MinosCodes/cdjay/docs/CDJ-800.md

# CDJ-800

## Introduction
The CDJ-800 MK2, unlike the CDJ-100, but like the 200, has a dedicated board with an own controller for the switches, jog dial etc. This means that we do not need to implement an own controller circuit, but can 'just' communicate with the interface board.

## Mainboard Connectors
The Mainboard has two connectors for the CD-Player. These are not relevant for our project. We could think of adding connectors just to not have them dangling around. 
- CN102 for the spindle motor
- CN101 towards CN1101
The MAIN ASSY has two connectors relevant for our endeavour. CN301 (CD53) to the SECB ASSY and CN701 (CN801) to the JACK ASSY.

### CN301 (CK4192 - - TBB, 1MM Pitch FFC ZIF)
Pin | I/O | Description | Use?
----|-----|-------------|-----
1  |  -  | V+7M |
2  |  -  | V+7M | 
3  |  -  | V+7M | 
4  | - | GNDM |
5  | - | GNDM | 
6  | - | GNDM | 
7  | - | V+8A | (Comes from CN701) 
8  | - | V+3D |
9  | - | V+3D |
10 | - | GNDD | 
11 | - | GNDD | 
12 | - | GNDD | 
13 | - | GNDD | 
14 | - | GNDD | 
15 | - | V+6B | 
16 | - | GNDS |
17 | - | V+5P |
18 | I/O | JSDATA | 
19 | I | TSDI | Data IN
20 | I | RMIN |
21 | O | TSCS | Cable Select
22 | I/O | CONT1 | 
23 | O | TSDO | Data Out
24 | I/O | CONT2 | 
25 |  O | TSCLK | Clock

### CN701 (CK4176 - - TBB, 1MM Pitch FFC ZIF)
Pin | I/O | Description | Use?
----|-----|-------------|-----
1  |  O  | LOUT | Left audio output channel
2  |  -  | GNDA | Audio Ground
3  |  -  | GNDA | 
4  |  O  | ROUT | R audio output channel
5  | - | V+8A | 
6  | O | MUTE | Mutes the audio output
7  | -  | V-7A | 
8  | O | GNDDOUT | GND for digital audio output
9  | O | DOUT | Digital audio outpout

### Power Supply

What we we need: and I think that all comes from external, so we don't need to generate anything. (See Page 20)
V+7M 
V+8A
V+3D
V+6B
V+5P

On the regulator board, there are two ICs: IC92 and IC91. 
IC91: Takes V+6B and delivers V+3D
IC92: Takes V+10B and delivers V+7A

### References
 - [https://forum.arduino.cc/t/hacking-cdj800-display-communication-protocol/1133083?page=3]
 - [https://www.youtube.com/@edescrambler/videos]
 - [https://github.com/djgreeb/CDJ-1000mk3_new_life_project/blob/master/Reverse%20Engineering%20Pioneer%20CDJ-1000%20serial%20protocol.pdf]
 - [https://github.com/AlejandroPerez92/cdj800spi]
