MinosCodes/cdjay/docs/CDJ-100.md

# CDJ-100
## Intro

## Board Analysis
All CDJ-100 controls (buttons, sliders, etc.) are mounted on a board that sits in the top half of the shelf and is connected to the mainboard through a 36-Pin flex cable. 

The service manual lists the following pin labels:
CN701 - CN601
Pin | I/O | Description | Use?
----|-----|-------------|-----
1  |  -  | V+5V |
2  |  I  | ADIN | Pitch slider voltage input.
3  |  I  | CT | Slider center tap voltage input.
4  | _ | GNDD|
5  | I | JOG1 | Jog Wheel Encoder. V+5V -> GNDS. Interrupt input for jog dial pulses
6  | I | JOG2 | Jog Wheel Encoder. Jog dial pulse input
7  | I |KD2 | Key return lines. Pulled High when one of the switches is pressed
8  | I | KD1 |
9  | I | KD0 |
10 | O | S12 | FL segment output
11 | O | S1 | FL segment output To HOLD (KD0), TRKB (KD1), Play (KD2) switch
12 | O | S2 | To TIME (KD0), TRKF (KD1), CUE (KD2) switch
13 | O | S3 | To EJECT (KD0), JET (KD1), SCNB (KD2) switch 
14 | O | S4 | To MT (Master Tempo) (KD0), ZIP (KD1), SCNF (KD2) switch  Connected to Flip-Flop for LED on/off
15 | O | S5 | WAH Switch to KD1
16 | O | S6 |
17 | O | S7 |
18 | O | S8 | Connected to Flip-Flop for LED on/off
19 | O | S9 | Connected to Flip-Flop for LED on/off
20 | O | S10 |
21 | O | S11 |
22 | O | G11 | FL grid output 
23 | O | G10 |
24 | O | G9 | FL grid output  
25 |  O | G8 | 
26 |  O | G7 |
27 |  O | G6 |
28 |  O | G5 |
29 |  O | G4 |
30 |  O | G3 |
31 |  O | G2 |
32 |  O | G1 | Clock Input for Flip-Flop
33 |  - | V-BV | Voltage for the Play/Cue/Disc/Window LEDs
34 |  - | AC2 | AC Voltage for the LCD (Either 5V AC or 3V AC)
35 | - | GNDS |
36 | - | AC1 | AC Voltage for the LCD

To control all that, we need 

| No.| Purpose | 
| -- | -- |
| 1  |  ADC Input| 
| 1 | CT line
| 2 | Jog Wheel |
| 3 | Button Input | 
| 11 | G-Lines |
| 12 | S-Lines | 
|  | |
| 30 | Sum | 

### Switches: 
There are 13 switches in total

S601: TRACK SEARCH (<<)
S602: SEARCH (<<)
S603: PLAY/PAUSE 
S604: TRACK SEARCH (>>)
S605: SEARCH (>>)
S606: CUE
S607: DIGITAL JOG BREAK (JET)
S608: MASTER TEMPO
S609: DIGITAL JOG BREAK (ZIP)
S610: DIGITAL JOG BREAK (WAH)
S611: EJECT 
S613: TIME MODE/AUTO CUE
S615: DIGITAL JOG BREAK (HPLD)

The Transformer Board Assembly has the following outputs:
CN705
Pin | Description | Use?
----|-------------|-----
1  | AC2 |
2  | AC1 |
3  | VLOAD | -31V for the VFD controller
4  | Audio R| The Audio connectors are located on the Transformer Board,
5  | GNDA | The Audio connectors are located on the Transformer Board,
6  | Audio L | The Audio connectors are located on the Transformer Board,
7  | CONT2 | Control Port Pins
8  | CONT1 | Control Port Pins (for Fader Start etc.)
9  | V+5V |
10 | GNDD |
11 | /RST | Comes straight from the 5V regulator output, keeps MCU off until power is stable
12 | V+BV |
13 | GNDS |
14 | V-BV |

## Display
### Pin Connection
| Pin No. | 1  | 2  | 3  | 4  | 5  | 6  | 7  | 8  | 9  | 10 | 11 | 12 | 13  | 14  | 15 | 16 | 17 | 18 | 19 | 20 | 21 | 22 | 23 | 24 | 25 | 26 | 27 | 28 | 29 | 30 | 31 | 32 | 33 | 34 | 35 | 
|---|----|----|----|----|----|----|----|----|----|----|----|----|-----|-----|----|----|----|----|----|----|----|----|----|----|----|----|----|----|----| ----|----|----|----|----|----|
| Assignment | F1 | F1 | NP | S1 | S2 | S3 | S4 | S5 | S6 | S7 | S8 | S9 | S10 | S11 | S12 | S13 | S14 | S15 | NL | NL | NL | G1 | G2 | G3 | G4 | G5 | G6 | G7 | G8 | G9 | G10 | G11 | NP | F2 | F2 |
| Signal | AC1 | AC1 | | S1 | S2 | S3| AC2 | S4 | S5 | S6 | S6 | S7 | S8 | S9 |  S3 | S10 | S11 | S12 |  NL | NL | NL | G1 | G2 | G3 | G4 | G5 | G6 | G7 | G8 | G9 | G10 | G11 | NP | AC2 | AC2 |

- F1, F2: Filament 
- S1 to S15: Anode 
- NL: No Lead
- G1 to G11: Grid
- NP: No pin

## Working Principle

### Switches
The switches are read through multplexing using the lines S1-5 as Outputs and KD0-2 as Inputs.
To figure out which switch is pressed, pull S1 high, read KD0-3, set S1 log, set S2 high, read KD0-3, set S2 Low,...

So far so good. But at the same time S1-15 are also used to drive the display, so all that needs to work with quite some refresh rate. That should be measureable by probing G1 with an oscilloscope. Yes it is, ~100Hz

### Display

The display in the CDJ-100 is a Vacuum Fluorescent Display (VFD) and these are a bit different than an LCD, which is why we need a special controller. 

The display is split in 11 grids with 12 segments.
The G1-G11 lines are used to activate the respective Grid, whose value can then be set using the S1-12 lines. Since we don't have 15, but only 12 S-Lines there needs to be a trick somewhere. 
Pin 6 and Pin 15 (S3 & S12) share the same signal S3 to form a vertical line on the 14-segment characters (G3 to G8).
Pin 10 and 11 (S7 & S8)  share the same signal S6 form a horizontal line on the 14-segment characters (G3 to G8).

Driving a VFD requires some unusual voltages. While enabling a segment is done by applying +5V, it is immediately disabled again by applying a negative bias voltage to increase contrast. The original display driver uses -30V as bias voltage. 

The PT6324 Dislpay Driver IC [Info](https://support.newhavendisplay.com/hc/en-us/articles/4415098171159-PT6324) [Datasheet](https://support.newhavendisplay.com/hc/en-us/article_attachments/4415110153623) seems to be the right choice as it offers 16 Grids and 64 Segments. The PT6312 is cheaper but can only drive 11 groups with 11 segments max, while we need 11 groups with 12 segments. 

There are some libraries out there to use these familiar chips.
https://github.com/the-real-mcarn/PT6302
https://github.com/ysard/PT6312_VFD_Arduino_Library

The LC75710 is also a good candidate. 

The -30V Bias Voltage, luckily, comes from the trans board assy as VLOAD.

### Level conversion
The entire CDJ-100 is built around 5V logic. Most modern MCUs are 3.3V, and at best, 5V-Tolerant, so we need to shift levels at various stages. 
The thing is that we have different types of signals: SPI and the KDx-Lines for the buttons are active-high signals, while CONT1+2, JOG1,2 and I2C are active-low. Depending on the type of signal, we need slightly different level-shifters. 

Level-shifting is required for the SPI to the display controller. For that we need a level-shifter without internal pull-ups, e.g., TXB0108. Since we have pin-capacity on that end, we can also convert KDx. 

For the Control-signals which go to external CDJs, the level is clamped to 0-5V on the original mainboard. In that case, we use a TXS0108, which we can also use for I2C, and the JOG12. 

#### Synchronizing with the chip for multiplexing the button readout

We need a way to synchronize with the chip in order to read out the KD-Lines. We cannot do that in parallel since the Values on the S1 to S5 depend on what's going to be shown on screen. 

However, we have some unused G-Lines from the PT6302 which we can use as trigger on the RPi. If we connect these to inputs, and set the S-Lines accordingly, we can get an interrupt, read KD0-2 and be happy. We have 16 Group outputs on the PT6324, of which only 11 are used for the display. The remaining 5, G12-G16, are connected to the RPi (don't forget the Diodes). We set the content of these groups to fixed outputs, i.e., for G12 only S1 is enabled, for G13 only S2 is enabled, ..., for G16 only G5 is enabled. This contradicts the idea of multiplexing to save pins a bit, but since we don't have a direct synchronization between the display controller and the RPi, this seems like a feasible solution. 

### LEDs
The LEDs are controlled through line S4, S8, S9 and group 1. The trick here, is that in group 1, these lines are not used, therefore ignored and can thus be used to drive the LEDs. The according segments need to be enabled disabled in the display driver. 

### Pitch Fader
The pitch fader is a classical adjustable voltage divider. At minimum, the output voltage ADIN is 0V, whereas at maximum, it is +5V. The neutral position (0%) is important in order to play tracks at their original speed. In order to compensate possible fader drift through ageing, the circuit has the CT-output. This returns a constant voltage. Connect this to an ADC to have the exact reference for ADIN at the neutral position. 

The VREF for the ADC is +5V. The GNDREF for the ADC is GNDD. 

The problem here is that the DISP-Assembly clamps both signals to 0-5V using diodes, which makes a simple voltage divider useless since the lower leg of the voltage divider is in parallel with one diode, meaning that we will never be able to reduce the voltage in a consistent replicable way for the 3.3V ADC on the Pico. On the original board, CT stays completely stable over the entire range of the fader, while with a voltage divider, it starts fluctuating. While symmetrical, this makes the fader unreliable. Therefore, we use a 5V ADC (ADS1115) and connect it to the Pico using a Level-Shifter (TSX0108).

## Connections:

I2S - Audio
SPI - Display
Encoder 
Jog-Wheel 
Pitch-Fader
KDO-KD2

### Fader Start Control
• Standard CD trigger format
° ⅛" (3.5 mm) mini TRS jacks
° Start pulse on Tip.
° Stop pulse on Ring/Sleeve.
° Normally high – Active low.
° Pulse width is 20 ms.
° Start threshold is at –65 dB of control attenuation.
° Stop threshold is at –75 dB of control attenuation.
