MinosCodes/cdjay/Boards/CDJAY100S/CDJAY100S.pdf

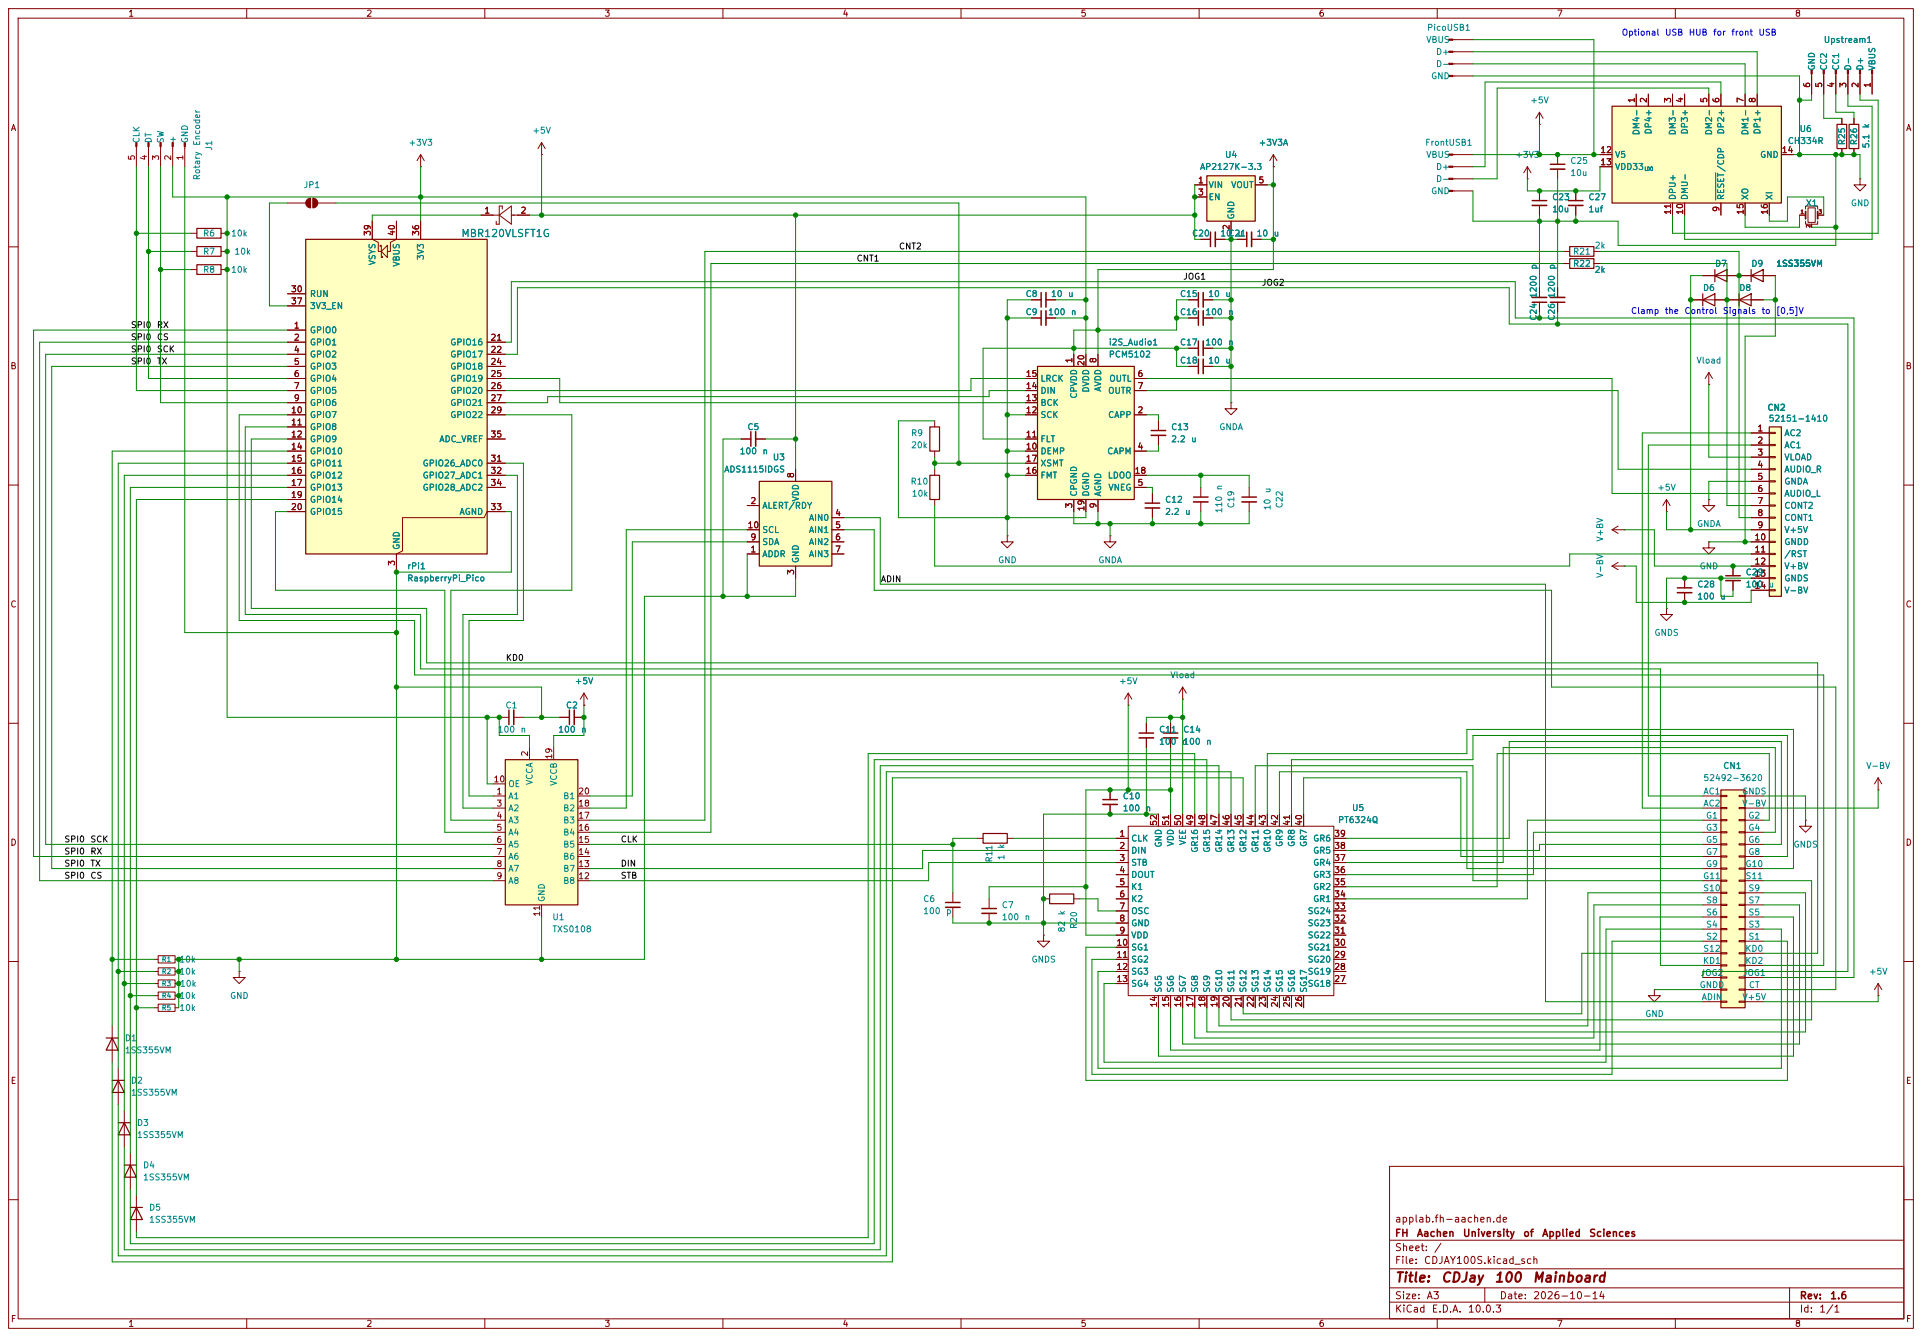
[picture p1: page 1]

Optional USB HUB for front USB

SPI0 SCK
SPI0 TX

SCK 12 BCK 13 DIN 14 LRCK 15

2 2
3 3

S8 | S7
S6 | S5
S4 | S3
S2 | S1
S12 | KD0

VDD 9

applab.fh-aachen.de
FH Aachen University of Applied Sciences
Sheet: /
File: CDJAY100S.kicad_sch
Title: CDJay 100 Mainboard

Size: A3 | Rev: 1.6 | F Date: 2026-10-14
KiCad E.D.A. 10.0.3 | Id: 1/1
