MinosCodes/cdjay/Boards/CDJAY100S/CDJAY100S.kicad_pcb

## KiCad design Boards/CDJAY100S/CDJAY100S.kicad_pcb (2026-10-23)

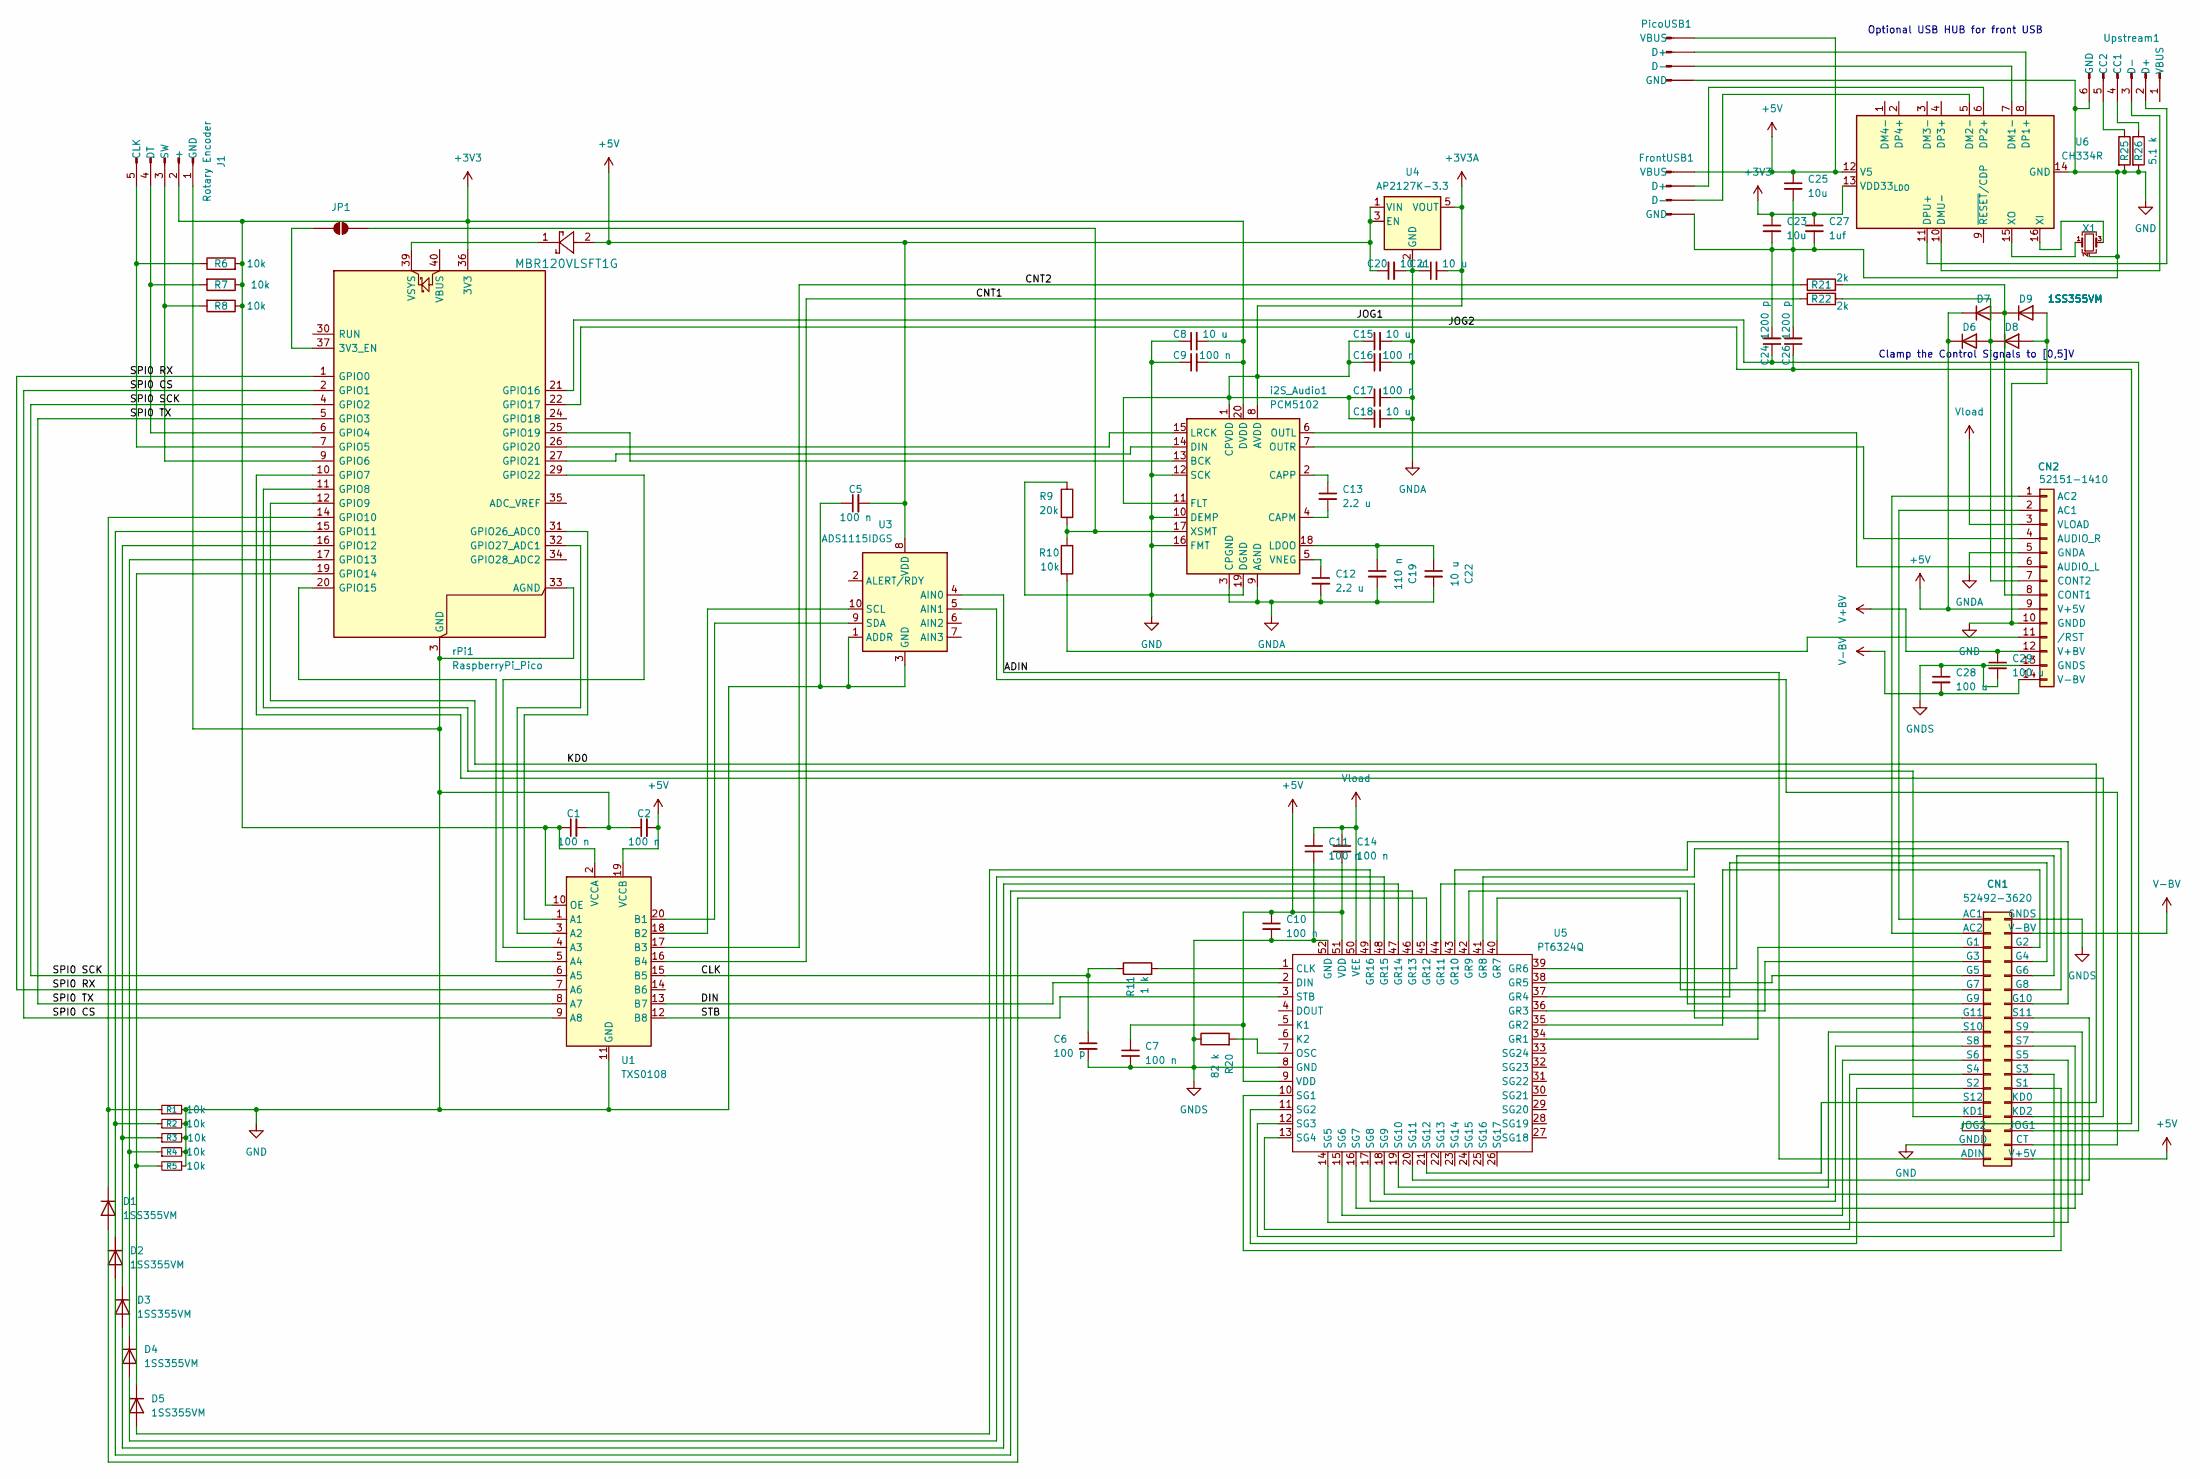
[picture p2: schematic CDJAY100S.kicad_sch, CDJay 100 Mainboard]

Parts:
C1, C2, C5, C7, C9, C10, C11, C14, C16, C17: 100 n; C_1206_3216Metric_Pad1.33x1.80mm_HandSolder
C6: 100 p; C_1206_3216Metric_Pad1.33x1.80mm_HandSolder
C8, C15, C18, C20, C21, C22: 10 u; C_1206_3216Metric_Pad1.33x1.80mm_HandSolder
C12, C13: 2.2 u; C_1206_3216Metric_Pad1.33x1.80mm_HandSolder
C19: 110 n; C_1206_3216Metric_Pad1.33x1.80mm_HandSolder
C23, C25: 10u; C_1206_3216Metric_Pad1.33x1.80mm_HandSolder
C24, C26: 1200 p; C_1206_3216Metric_Pad1.33x1.80mm_HandSolder
C27: 1uf; C_1206_3216Metric_Pad1.33x1.80mm_HandSolder
C28, C29: 100 u; C_1206_3216Metric_Pad1.33x1.80mm_HandSolder
CN1: 52492-3620; ConnectorFPC&FFC_MOL52045-3645-36P_1
CN2: 52151-1410; PinHeader_1x14_P2.00mm_Vertical
CNT1: MBR120VLSFT1G; Nexperia_CFP3_SOD-123W
D1, D2, D3, D4, D5, D6, D7, D8, D9: 1SS355VM; Nexperia_CFP3_SOD-123W
FrontUSB1: Conn_01x04_Pin; PinHeader_1x04_P2.54mm_Vertical
J1: Rotary Encoder; PinHeader_1x05_P2.54mm_Vertical
JP1: SolderJumper_2_Open; SolderJumper-2_P1.3mm_Open_Pad1.0x1.5mm
PicoUSB1: Conn_01x04_Pin; PinHeader_1x04_P2.54mm_Vertical
R1, R2, R3, R4, R5, R6, R7, R8, R10: 10k; R_1206_3216Metric_Pad1.30x1.75mm_HandSolder
R9: 20k; R_1206_3216Metric_Pad1.30x1.75mm_HandSolder
R11: 1 k; R_1206_3216Metric_Pad1.30x1.75mm_HandSolder
R20: 82 k; R_1206_3216Metric_Pad1.30x1.75mm_HandSolder
R21, R22: 2k; R_1206_3216Metric_Pad1.30x1.75mm_HandSolder
R25, R26: 5.1 k; R_1206_3216Metric_Pad1.30x1.75mm_HandSolder
U1: TXS0108; TSSOP-20_4.4x6.5mm_P0.65mm
U3: ADS1115IDGS; TSSOP-10_3x3mm_P0.5mm
U4: AP2127K-3.3; SOT-23-5
U5: PT6324Q; QFP-52_14x14mm_P1mm_1
U6: CH334R; QSOP-16_3.9x4.9mm_P0.635mm
Upstream1: Conn_01x06_Pin; PinHeader_1x06_P2.54mm_Vertical
X1: 12MHz; Crystal_SMD_3225-4Pin_3.2x2.5mm_HandSoldering
i2S_Audio1: PCM5102; TSSOP-20_4.4x6.5mm_P0.65mm; PARTREV C
rPi1: RaspberryPi_Pico; RaspberryPi_Pico_Common_Unspecified

Connections:
+3V3: C1.1, C8.2, C9.2, C23.1, C27.1, J1.2 (+), R6.2, R7.1, R8.1, U1.2 (VCCA), U1.10 (OE), U6.13 (VDD33_{LDO}), i2S_Audio1.20 (DVDD), rPi1.36 (3V3)
+3V3A: C15.1, C16.1, C17.1, C18.1, C21.2, U4.5 (VOUT), i2S_Audio1.1 (CPVDD), i2S_Audio1.8 (AVDD), i2S_Audio1.11 (FLT)
+5V: C2.2, C5.2, C7.1, C10.1, C14.2, C20.1, C25.1, CN1.1 (V+5V), CN2.9 (V+5V), CNT1.2, D6.1 (K), D7.1 (K), FrontUSB1.1 (VBUS), PicoUSB1.1 (VBUS), U1.19 (VCCB), U3.8 (VDD), U4.1 (VIN), U4.3 (EN), U5.9 (VDD), U5.51 (VDD), U6.12 (V5)
/ADIN: CN1.2 (ADIN), U3.4 (AIN0)
/CLK: C6.1, R11.1, U1.15 (B5)
/CNT1: R22.1, U1.16 (B4)
/CNT2: R21.1, U1.17 (B3)
/DIN: U1.13 (B7), U5.2 (DIN)
/JOG1: C24.1, CN1.5 (JOG1), rPi1.21 (GPIO16)
/KD0: CN1.9 (KD0), rPi1.12 (GPIO9)
/SPI0 CS: U1.9 (A8), rPi1.2 (GPIO1)
/SPI0 RX: U1.7 (A6), rPi1.1 (GPIO0)
/SPI0 SCK: U1.6 (A5), rPi1.4 (GPIO2)
/SPI0 TX: U1.8 (A7), rPi1.5 (GPIO3)
/STB: U1.12 (B8), U5.3 (STB)
GNDA: C12.2, C15.2, C16.2, C17.2, C18.2, C19.2, C20.2, C21.1, C22.2, CN2.5 (GNDA), U4.2 (GND), i2S_Audio1.3 (CPGND), i2S_Audio1.9 (AGND)
GNDS: C6.2, C7.2, C10.2, C11.2, C28.1, C29.2, CN1.35 (GNDS), CN2.13 (GNDS), R20.1, U5.8 (GND), U5.52 (GND)
unnamed: CN1.36 (AC1), CN2.2 (AC1)
unnamed: CN1.34 (AC2), CN2.1 (AC2)
unnamed: CN1.3 (CT), U3.5 (AIN1)
unnamed: CN1.32 (G1), U5.34 (GR1)
unnamed: CN1.31 (G2), U5.35 (GR2)
unnamed: CN1.30 (G3), U5.36 (GR3)
unnamed: CN1.29 (G4), U5.37 (GR4)
unnamed: CN1.28 (G5), U5.38 (GR5)
unnamed: CN1.27 (G6), U5.39 (GR6)
unnamed: CN1.26 (G7), U5.40 (GR7)
unnamed: CN1.25 (G8), U5.41 (GR8)
unnamed: CN1.24 (G9), U5.42 (GR9)
unnamed: CN1.23 (G10), U5.43 (GR10)
unnamed: CN1.22 (G11), U5.44 (GR11)
unnamed: CN1.8 (KD1), rPi1.11 (GPIO8)
unnamed: CN1.7 (KD2), rPi1.10 (GPIO7)
unnamed: CN1.11 (S1), U5.10 (SG1)
unnamed: CN1.12 (S2), U5.11 (SG2)
unnamed: CN1.13 (S3), U5.12 (SG3)
unnamed: CN1.14 (S4), U5.13 (SG4)
unnamed: CN1.15 (S5), U5.14 (SG5)
unnamed: CN1.16 (S6), U5.15 (SG6)
unnamed: CN1.17 (S7), U5.16 (SG7)
unnamed: CN1.18 (S8), U5.17 (SG8)
unnamed: CN1.19 (S9), U5.18 (SG9)
unnamed: CN1.20 (S10), U5.19 (SG10)
unnamed: CN1.21 (S11), U5.20 (SG11)
unnamed: CN1.10 (S12), U5.21 (SG12)
unnamed: CN2.6 (AUDIO_L), i2S_Audio1.6 (OUTL)
unnamed: CN2.4 (AUDIO_R), i2S_Audio1.7 (OUTR)
unnamed: CN2.8 (CONT1), D7.2 (A), D9.1 (K), R21.2
unnamed: CN2.7 (CONT2), D6.2 (A), D8.1 (K), R22.2
unnamed: CN2.11 (/RST), R10.2
unnamed: D1.2 (A), U5.45 (GR12)
unnamed: D1.1 (K), R1.1, rPi1.14 (GPIO10)
unnamed: D2.2 (A), U5.46 (GR13)
unnamed: D2.1 (K), R2.1, rPi1.15 (GPIO11)
unnamed: D3.2 (A), U5.47 (GR14)
unnamed: D3.1 (K), R3.1, rPi1.16 (GPIO12)
unnamed: D4.2 (A), U5.48 (GR15)
unnamed: D4.1 (K), R4.1, rPi1.17 (GPIO13)
unnamed: D5.2 (A), U5.49 (GR16)
unnamed: D5.1 (K), R5.2, rPi1.19 (GPIO14)
unnamed: FrontUSB1.2 (D+), U6.6 (DP2+)
unnamed: FrontUSB1.3 (D-), U6.5 (DM2-)
unnamed: J1.5 (CLK), R6.1, rPi1.7 (GPIO5)
unnamed: J1.4 (DT), R7.2, rPi1.6 (GPIO4)
unnamed: J1.3 (SW), R8.2, rPi1.9 (GPIO6)
unnamed: JP1.1 (A), rPi1.37 (3V3_EN)
unnamed: JP1.2 (B), R9.2, R10.1, i2S_Audio1.17 (XSMT)
unnamed: PicoUSB1.2 (D+), U6.8 (DP1+)
unnamed: PicoUSB1.3 (D-), U6.7 (DM1-)
unnamed: U1.1 (A1), rPi1.31 (GPIO26_ADC0)
unnamed: U1.3 (A2), rPi1.32 (GPIO27_ADC1)
unnamed: U1.4 (A3), rPi1.29 (GPIO22)
unnamed: U1.5 (A4), rPi1.20 (GPIO15)
unnamed: U1.20 (B1), U3.9 (SDA)
unnamed: U1.18 (B2), U3.10 (SCL)
unnamed: R11.2, U5.1 (CLK)
unnamed: R20.2, U5.7 (OSC)
unnamed: U6.10 (DMU-), Upstream1.3 (D-)
unnamed: U6.11 (DPU+), Upstream1.2 (D+)
unnamed: U6.16 (XI), X1.3
unnamed: U6.15 (XO), X1.1
unnamed: R26.1, Upstream1.4 (CC1)
unnamed: R25.1, Upstream1.5 (CC2)
unnamed: i2S_Audio1.13 (BCK), rPi1.25 (GPIO19)
unnamed: C13.2, i2S_Audio1.4 (CAPM)
unnamed: C13.1, i2S_Audio1.2 (CAPP)
unnamed: i2S_Audio1.14 (DIN), rPi1.27 (GPIO21)
unnamed: C19.1, C22.1, i2S_Audio1.18 (LDOO)
unnamed: i2S_Audio1.15 (LRCK), rPi1.26 (GPIO20)
unnamed: C12.1, i2S_Audio1.5 (VNEG)
unnamed: CNT1.1, rPi1.39 (VSYS)
V+BV: C29.1, CN2.12 (V+BV)
V-BV: C28.2, CN1.33 (V-BV), CN2.14 (V-BV)
Vload: C11.1, C14.1, CN2.3 (VLOAD), U5.50 (VEE)

Notes on the sheet:
Clamp the Control Signals to [0,5]V
Optional USB HUB for front USB

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
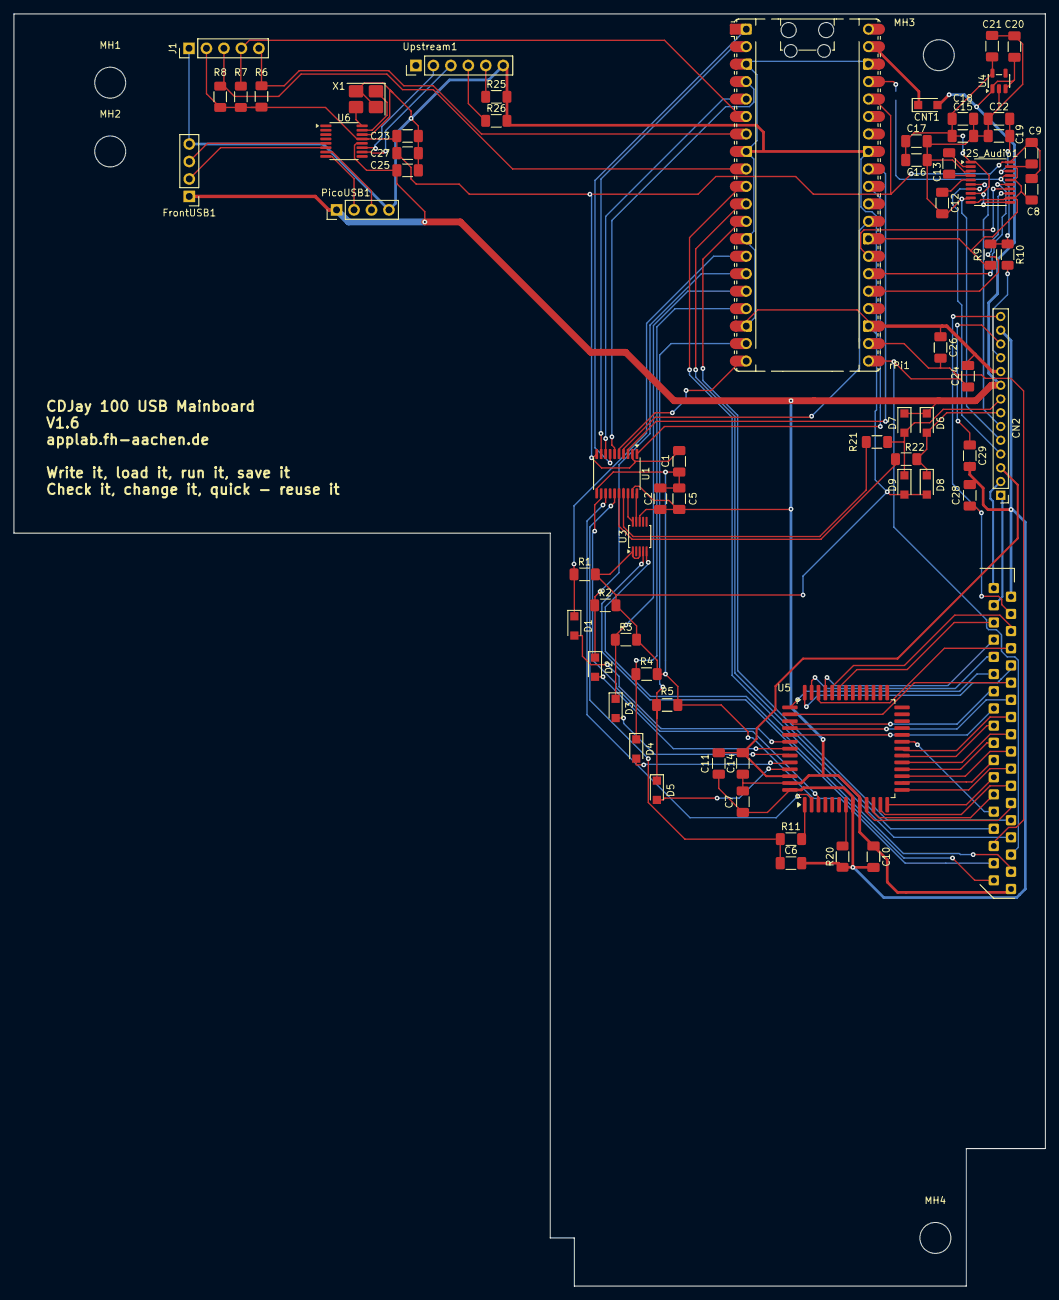
[picture p3: board CDJAY100S.kicad_pcb from above]

Board: 2 copper layers, 150.0 x 185.0 mm, 72 parts (1 on the bottom side), 96 nets.

Other parts of the board:
MH1, MH2, MH3, MH4: MountingHole_4.5mm
