MinosCodes/cdjay/(commit log)

2026-10-14 Updated the board to have an own power supply for the DAC, and an own ADC for the Pitch fader
    [CDJAY100S.kicad_pcb, CDJAY100S.kicad_sch]
2026-10-16 Reorganize some traces
    [CDJAY100S.kicad_pcb, CDJAY100S.kicad_sch]
2026-10-18 Renamed the components to consistent placement
    [CDJAY100S.kicad_pcb, CDJAY100S.kicad_sch]
2026-10-18 Switch the level converters
    [CDJ-800.kicad_sch]
2026-10-23 Version 1.6
    [CDJAY100S.kicad_pcb, CDJAY100S.kicad_sch]
2026-10-23 Small mistake in the silkscreen of CN1
    [CDJAY100S.kicad_pcb]
2026-10-23 Updated Gerbers
    [CDJAY100S-B_Cu.gbr, CDJAY100S-B_Mask.gbr, CDJAY100S-B_Paste.gbr, CDJAY100S-B_Silkscreen.gbr, CDJAY100S-Edge_Cuts.gbr, CDJAY100S-F_Cu.gbr, CDJAY100S-F_Mask.gbr, CDJAY100S-F_Paste.gbr]
2026-10-23 Export the Gerbers when needed
    [CDJAY100S-B_Cu.gbr, CDJAY100S-B_Mask.gbr, CDJAY100S-B_Paste.gbr, CDJAY100S-B_Silkscreen.gbr, CDJAY100S-Edge_Cuts.gbr, CDJAY100S-F_Cu.gbr, CDJAY100S-F_Mask.gbr, CDJAY100S-F_Paste.gbr]
2026-10-23 Schematic Export
2026-10-29 Add CDJ-850 USB-MIDI firmware, PlatformIO config, and Pico C SDK bridge
