MinosCodes/cdjay/(notices)

Notices in the files:
Boards/CDJAY100S/CDJAY100S.kicad_pcb:
CC-By-SA
